morgobongo/Mini_Synth/ESP32/include/HardwarePins.h

#pragma once

// ---------------------------------------------------------
// PUSH BUTTONS
// ---------------------------------------------------------
#define PIN_BUTTON_PRESET 33
#define PIN_BUTTON_OCTAVE 15

// ---------------------------------------------------------
// KEYBOARD MATRIX PINS
// ---------------------------------------------------------
#define PIN_MATRIX_ROW_1 4
#define PIN_MATRIX_ROW_2 16
#define PIN_MATRIX_ROW_3 17
#define PIN_MATRIX_ROW_4 18

#define PIN_MATRIX_COL_1 13
#define PIN_MATRIX_COL_2 12
#define PIN_MATRIX_COL_3 14
#define PIN_MATRIX_COL_4 27
#define PIN_MATRIX_COL_5 32
