morgobongo/Mini_Synth/(commit log)

2026-10-06 Project refactoring
    [Door holder 2.stl, button_adapter.stl, custom_button.scad, custom_button.stl, custom_button_flat.scad, custom_button_hole_4mm.scad, enclosure.scad, keyboard_matrix.kicad_pcb]
2026-10-06 Refactor OpenSCAD codebase & rewrite README
    [enclosure.scad, scout.scad]
2026-10-06 Add preset preview sample & reset octave on mode change
    [main.cpp]
2026-10-06 Fix enclosure_top floating nub, convert corner reinforcements to square prisms, update zip and README
    [enclosure.scad, keys.scad]
2026-10-06 docs: fix documentation on custom buttons and adapters
2026-10-07 Fix MIDI ghosting with custom matrix scanner, rate limit MIDI, add sustain pedal mode, and adjust LED brightness
    [KeyBuffer.cpp, KeyBuffer.h, MidiManager.cpp, MidiManager.h, main.cpp]
